AndreiVladescu/ESP32-Component-Tester/(list of files, cad)

Other CAD files:
mechanical/wifi_component_tester_case.f3d
