AndreiVladescu/ESP32-Component-Tester/pcb/esp32-comp-tester.pdf

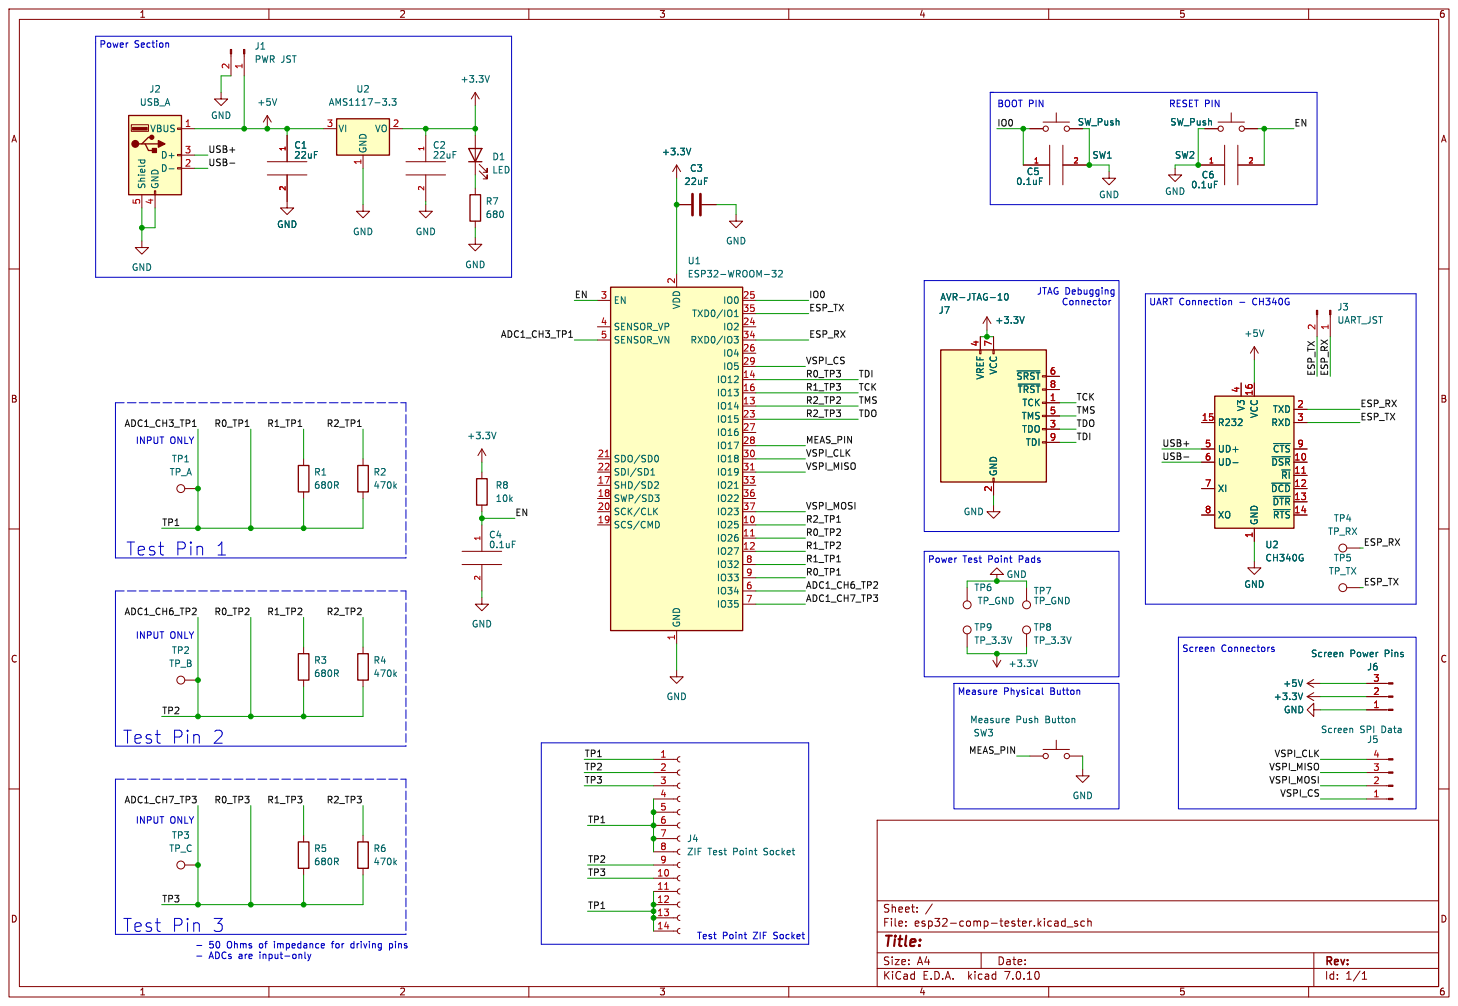
[picture p1: page 1]

Power Section Test Pin 2
LED GND GND GND

2 SCK/CLK 20 SDO/SD0 21 SDI/SD1 22

1 ~{DSR} 10 ~{RI} 11 ~{DCD} 12 ~{DTR} 13 ~{RTS} 14 R232 15 VCC 16 TXD 2 RXD 3 V3

4 UD+ 5 UD- 6 XI 7 XO 8 ~{CTS}9 U2 CH340G

4 UD+ 5 UD- 6 XI 7 XO 8 ~{CTS}9 GND

INPUT ONLY Test Pin 1

Screen Connectors Power Test Point Pads
TP8 TP_3.3V GND

INPUT ONLY Test Pin 3

Id: 1/1 Title: File: esp32-comp-tester.kicad_sch Sheet: /

- ADCs are input-only
