AndreiVladescu/ESP32-Component-Tester/pcb/esp32-comp-tester.kicad_pcb

## KiCad design pcb/esp32-comp-tester.kicad_pcb (2024-08-01)

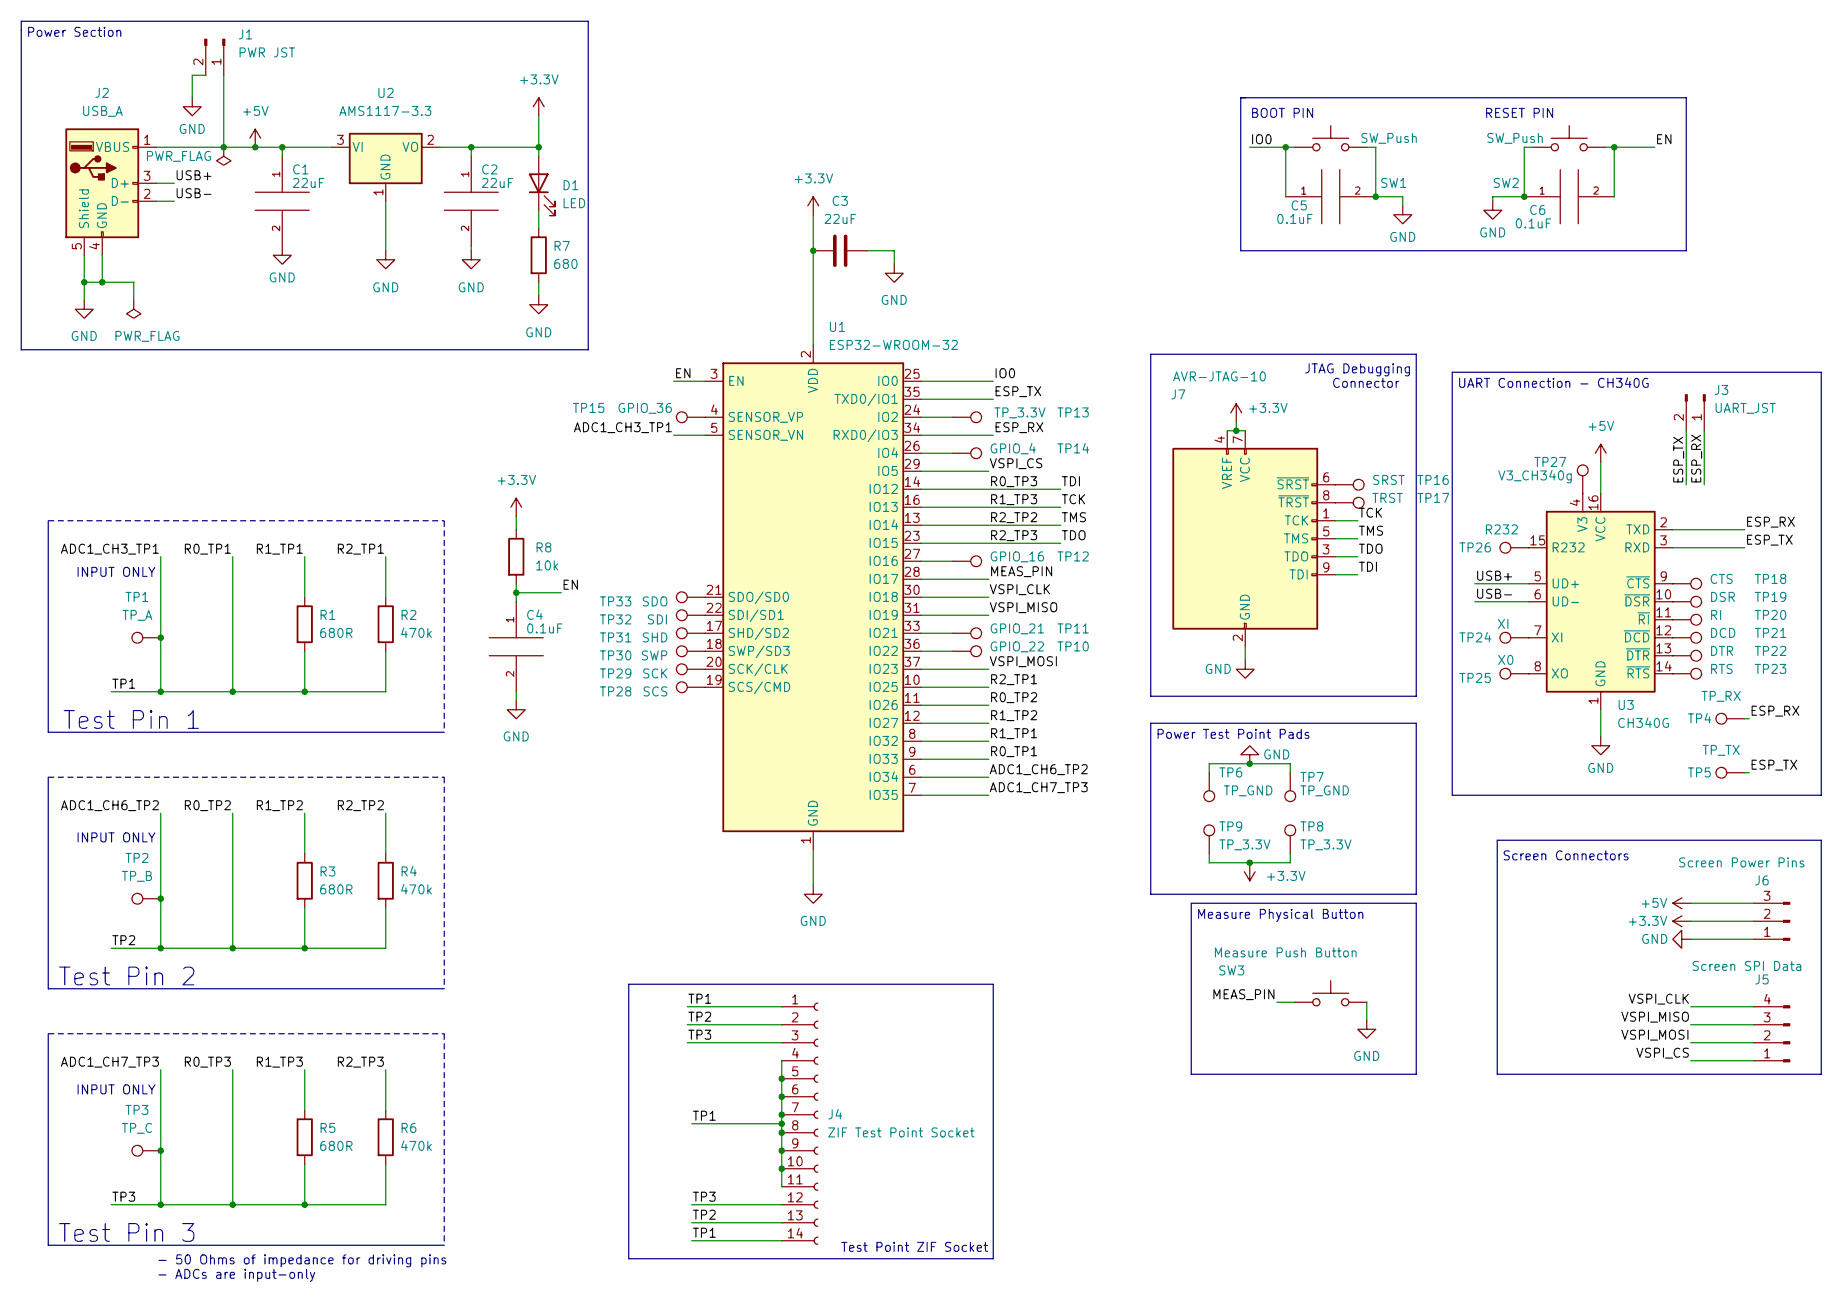
[picture p2: schematic esp32-comp-tester.kicad_sch]

Parts:
C1, C2, C3: 22uF; C_1206_3216Metric
C4, C5, C6: 0.1uF; C_0603_1608Metric
D1: LED; LED_1206_3216Metric
J1: PWR JST; PinSocket_1x02_P2.54mm_Vertical
J2: USB_A; USB_A_Molex_48037-2200_Horizontal
J3: UART_JST; PinSocket_1x02_P2.54mm_Vertical
J4: ZIF Test Point Socket; DIP-14_W7.62mm_Socket
J5: Screen SPI Data; JST_EH_B4B-EH-A_1x04_P2.50mm_Vertical
J6: Screen Power Pins; JST_EH_B3B-EH-A_1x03_P2.50mm_Vertical
J7: AVR-JTAG-10; IDC-Header_2x05_P2.54mm_Vertical
R1, R3, R5: 680R; R_1206_3216Metric
R2, R4, R6: 470k; R_1206_3216Metric
R7: 680; R_1206_3216Metric
R8: 10k; R_1206_3216Metric
SW1, SW2: SW_Push; SW_SPST_B3S-1000
SW3: Measure Push Button; SW_SPST_B3S-1100
TP1: TP_A; TestPoint_Pad_D2.0mm
TP2: TP_B; TestPoint_Pad_D2.0mm
TP3: TP_C; TestPoint_Pad_D2.0mm
TP4: TP_RX; TestPoint_Pad_D2.0mm
TP5: TP_TX; TestPoint_Pad_D2.0mm
TP6, TP7: TP_GND; TestPoint_Pad_D2.0mm
TP8, TP9, TP13: TP_3.3V; TestPoint_Pad_D2.0mm
TP10: GPIO_22; TestPoint_Pad_D2.0mm
TP11: GPIO_21; TestPoint_Pad_D2.0mm
TP12: GPIO_16; TestPoint_Pad_D2.0mm
TP14: GPIO_4; TestPoint_Pad_D2.0mm
TP15: GPIO_36; TestPoint_Pad_D2.0mm
TP16: SRST; TestPoint_Pad_D2.0mm
TP17: TRST; TestPoint_Pad_D2.0mm
TP18: CTS; TestPoint_Pad_D2.0mm
TP19: DSR; TestPoint_Pad_D2.0mm
TP20: RI; TestPoint_Pad_D2.0mm
TP21: DCD; TestPoint_Pad_D2.0mm
TP22: DTR; TestPoint_Pad_D2.0mm
TP23: RTS; TestPoint_Pad_D2.0mm
TP24: XI; TestPoint_Pad_D2.0mm
TP25: X0; TestPoint_Pad_D2.0mm
TP26: R232; TestPoint_Pad_D2.0mm
TP27: V3_CH340g; TestPoint_Pad_D2.0mm
TP28: SCS; TestPoint_Pad_D2.0mm
TP29: SCK; TestPoint_Pad_D2.0mm
TP30: SWP; TestPoint_Pad_D2.0mm
TP31: SHD; TestPoint_Pad_D2.0mm
TP32: SDI; TestPoint_Pad_D2.0mm
TP33: SDO; TestPoint_Pad_D2.0mm
U1: ESP32-WROOM-32
U2: AMS1117-3.3; SOT-223-3_TabPin2
U3: CH340G; SOIC-16_3.9x9.9mm_P1.27mm

Connections:
+3.3V: C2.1, C3.1, D1.2 (A), J6.2, J7.4 (VREF), J7.7 (VCC), R8.1, TP8.1, TP9.1, U1.2 (VDD), U2.2 (VO)
+5V: C1.1, J1.1, J2.1 (VBUS), J6.3, U2.3 (VI), U3.16 (VCC)
/ADC1_CH3_TP1: J4.1, J4.4, J4.5, J4.6, J4.7, J4.8, J4.9, J4.10, J4.11, J4.14, R1.2, R2.2, TP1.1, U1.5 (SENSOR_VN), U1.9 (IO33)
/ADC1_CH6_TP2: J4.2, J4.13, R3.2, R4.2, TP2.1, U1.6 (IO34), U1.11 (IO26)
/ADC1_CH7_TP3: J4.3, J4.12, J7.9 (TDI), R5.2, R6.2, TP3.1, U1.7 (IO35), U1.14 (IO12)
/EN: C4.1, C6.2, R8.2, SW2.2, U1.3 (EN)
/ESP_RX: J3.1, TP4.1, U1.34 (RXD0/IO3), U3.2 (TXD)
/ESP_TX: J3.2, TP5.1, U1.35 (TXD0/IO1), U3.3 (RXD)
/IO0: C5.1, SW1.1, U1.25 (IO0)
/MEAS_PIN: SW3.1, U1.28 (IO17)
/R1_TP1: R1.1, U1.8 (IO32)
/R1_TP2: R3.1, U1.12 (IO27)
/R1_TP3: J7.1 (TCK), R5.1, U1.16 (IO13)
/R2_TP1: R2.1, U1.10 (IO25)
/R2_TP2: J7.5 (TMS), R4.1, U1.13 (IO14)
/R2_TP3: J7.3 (TDO), R6.1, U1.23 (IO15)
/USB+: J2.3 (D+), U3.5 (UD+)
/USB-: J2.2 (D-), U3.6 (UD-)
/VSPI_CLK: J5.4, U1.30 (IO18)
/VSPI_CS: J5.1, U1.29 (IO5)
/VSPI_MISO: J5.3, U1.31 (IO19)
/VSPI_MOSI: J5.2, U1.37 (IO23)
GND: C1.2, C2.2, C3.2, C4.2, C5.2, C6.1, J1.2, J2.4 (GND), J2.5 (Shield), J6.1, J7.2 (GND), J7.10 (GND), R7.2, SW1.2, SW2.1, SW3.2, TP6.1, TP7.1, U1.1 (GND), U1.15 (GND), U1.38 (GND), U1.39 (GND), U2.1 (GND), U3.1 (GND)
unnamed: D1.1 (K), R7.1
unnamed: J7.6 (~SRST), TP16.1
unnamed: J7.8 (~TRST), TP17.1
unnamed: TP13.1, U1.24 (IO2)
unnamed: TP14.1, U1.26 (IO4)
unnamed: TP12.1, U1.27 (IO16)
unnamed: TP11.1, U1.33 (IO21)
unnamed: TP10.1, U1.36 (IO22)
unnamed: TP29.1, U1.20 (SCK/CLK)
unnamed: TP28.1, U1.19 (SCS/CMD)
unnamed: TP32.1, U1.22 (SDI/SD1)
unnamed: TP33.1, U1.21 (SDO/SD0)
unnamed: TP15.1, U1.4 (SENSOR_VP)
unnamed: TP31.1, U1.17 (SHD/SD2)
unnamed: TP30.1, U1.18 (SWP/SD3)
unnamed: TP26.1, U3.15 (R232)
unnamed: TP27.1, U3.4 (V3)
unnamed: TP24.1, U3.7 (XI)
unnamed: TP25.1, U3.8 (XO)
unnamed: TP18.1, U3.9 (~CTS)
unnamed: TP21.1, U3.12 (~DCD)
unnamed: TP19.1, U3.10 (~DSR)
unnamed: TP22.1, U3.13 (~DTR)
unnamed: TP20.1, U3.11 (~RI)
unnamed: TP23.1, U3.14 (~RTS)

Notes on the sheet:
INPUT ONLY
Screen Connectors
JTAG Debugging Connector
- 50 Ohms of impedance for driving pins - ADCs are input-only
Power Test Point Pads
Test Pin 1
BOOT PIN
Test Pin 3
Measure Physical Button
Power Section
UART Connection - CH340G
RESET PIN
Test Point ZIF Socket
Test Pin 2

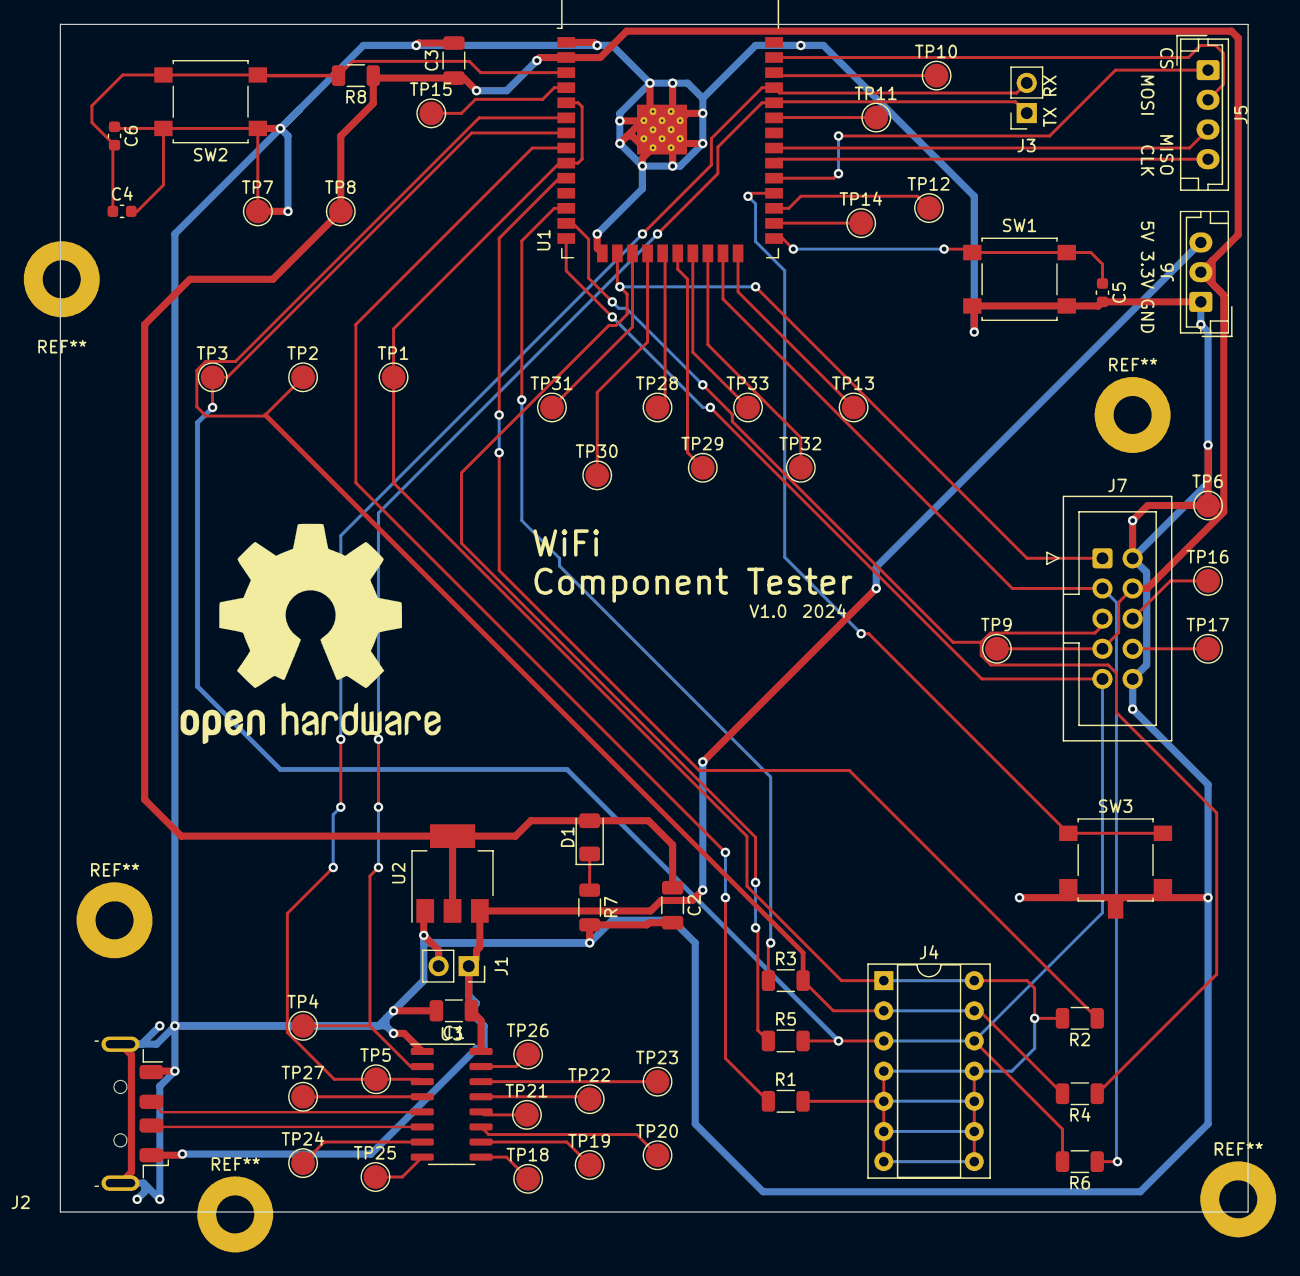
[picture p3: board esp32-comp-tester.kicad_pcb from above]

Board: 2 copper layers, 100.0 x 100.0 mm, 61 parts (0 on the bottom side), 48 nets.
