AndreiVladescu/ESP32-Component-Tester/(commit log)

2024-04-29 Added resistance measurement stubs
2024-04-29 Improved debug prints
2024-04-30 Added dummy threaded web server
2024-04-30 Fixed dynamic template + css
    [main.py]
2024-04-30 Resistance sanity check
2024-05-10 Added schematic
    [esp32-comp-tester.kicad_sch]
2024-05-13 Added "sys" missing import
    [main.py]
2024-05-13 Added capacitance measuring stubs
2024-05-13 Added KiCAD Project
    [esp32-comp-tester.kicad_pcb]
2024-05-14 Updated Schematic
    [esp32-comp-tester.kicad_sch]
2024-05-14 New pdf schematic
2024-05-15 Fixed resistance measuring
2024-05-16 Added capacitance measuring
2024-05-16 Fixed 470k resistance measuring
    [main.py]
2024-05-17 Added V1 PCB
    [esp32-comp-tester.kicad_pcb, esp32-comp-tester.kicad_sch]
2024-05-17 Little PCB Changes
    [esp32-comp-tester.kicad_sch]
2024-05-17 Resistance Measurement Averaging
2024-05-18 Added diode measuring
2024-05-18 Fixed capacitor testing
2024-05-20 Added case
2024-05-20 Added multiple case formats
    [wifi_component_tester_case.f3d]
2024-05-20 Added dc barrel jack
    [wifi_component_tester_case.f3d]
2024-05-20 Added measuring button
    [wifi_component_tester_case.f3d]
2024-05-20 Diode capacitor fix
2024-05-23 Added inductor measurement
    [esp32-comp-tester.kicad_pcb]
2024-08-01 Added quality and dissipation factors
    [esp32-comp-tester.csv, esp32-comp-tester.kicad_pcb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]
